realyocelestial/windtunnel/README.md

<h1> AeroFlow - A wind tunnel to visualize the airflow around objects using water vapor! </h1>
<h2>Link to Demo Video - https://www.youtube.com/watch?v=F6HdiybJe84</h2>
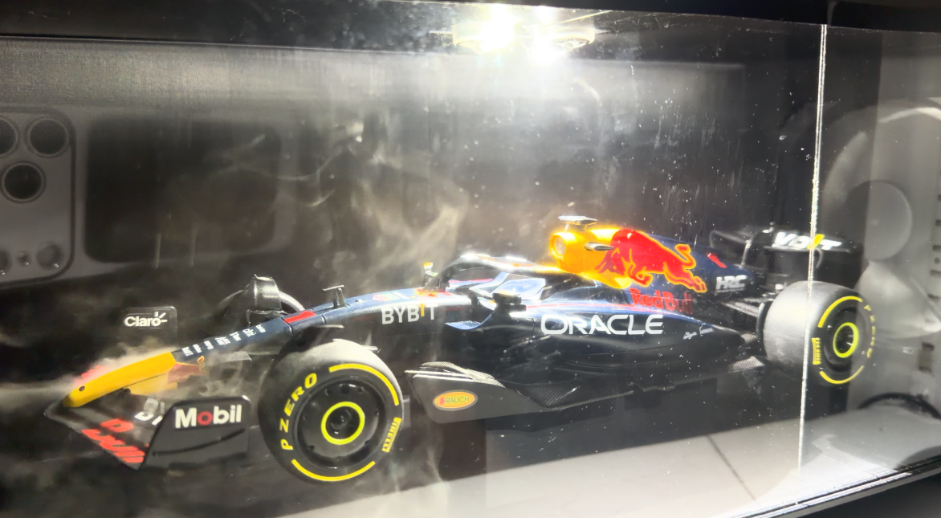
[picture p1: images/image1.png]

<h6>Best Looking Image!!!</h6>
<h2> Main Features </h2>
<ul>
  <li> Works with water vapor </li>
  <li> 3D-printed with some store bought parts </li>
  <li> 2 Heavy-duty humidifiers </li>
  <li> 120mm fan </li>
  <li> A flow shape that allows you to see many parts of the aerodynamics of a car </li>
  <li> Toggleable light on top </li>
  <li> Amazing demo video! </li>
</ul>

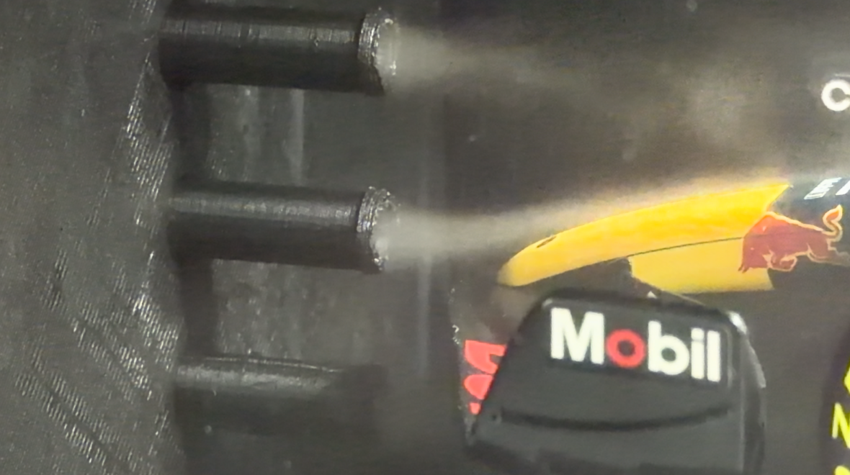
[picture p2: images/image2.png]

<h6>A demonstration of the flow!</h6>

<h2> How I Made It: </h2>
  The 3D models were made in Onshape. Hand assembled obviously. Printed with the Creality K1.
  The visualization works through sucking straightened water vapor through some tubes via a fan at the end of the tunnel
  The car is in between the tubes and the fan.

<h2> Credits </h2>
  <p>Project by @Celestial, for the Hack Club Stardance Challenge</p>
  <p>AI was used as a consultant for Onshape techniques</p>
  <p>Song used in the demonstration video: Lose My Mind by Don Toliver and Doja Cat, the F1 Movie.</p>

<h6>  I apologize for the first 11 commit messages; I did not know what the hell I was doing. im gonna try to make better commits in the future :) </h6>
