realyocelestial/windtunnel/Files/3D Models/Box Holder Thing/Box Holder Thing v1.step

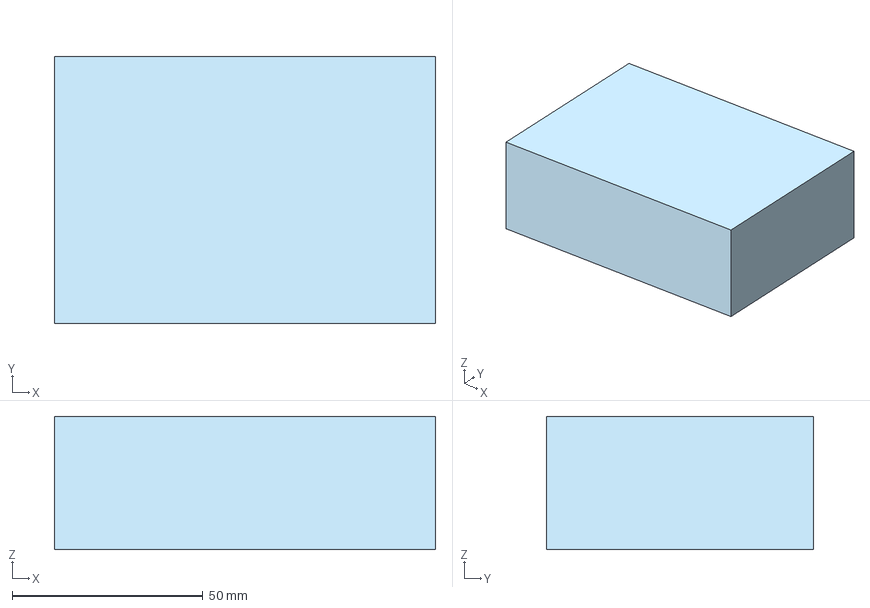
[picture p3: CAD file, 2026-10-28]
Files/3D Models/Box Holder Thing/Box Holder Thing v1.step
100.0 x 70.0 x 35.0 mm
