realyocelestial/windtunnel/Files/3D Models/Flow Shape Adapter/Flow Shape Adapter v1.step

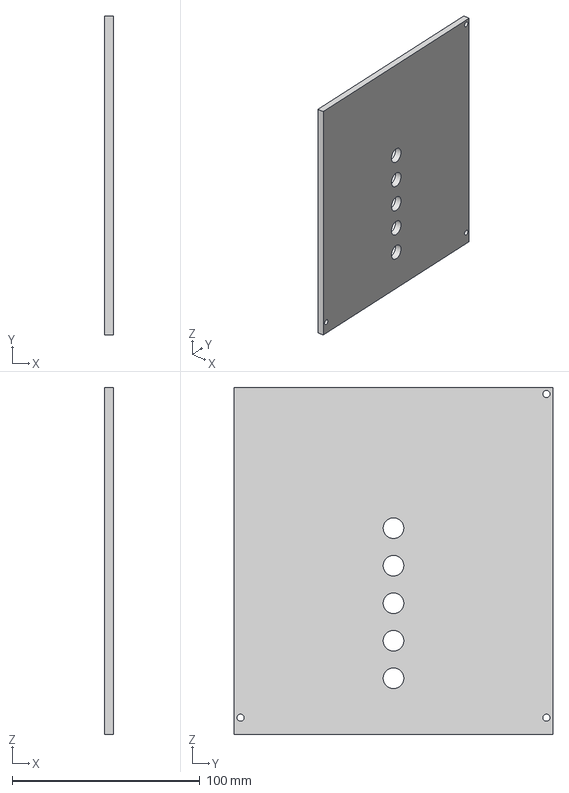
[picture p4: CAD file, 2026-10-25]
Files/3D Models/Flow Shape Adapter/Flow Shape Adapter v1.step
5.00 x 170.0 x 185.0 mm
