realyocelestial/windtunnel/Files/3D Models/Flow Shape Holder/Flow Shape Holder v2.step

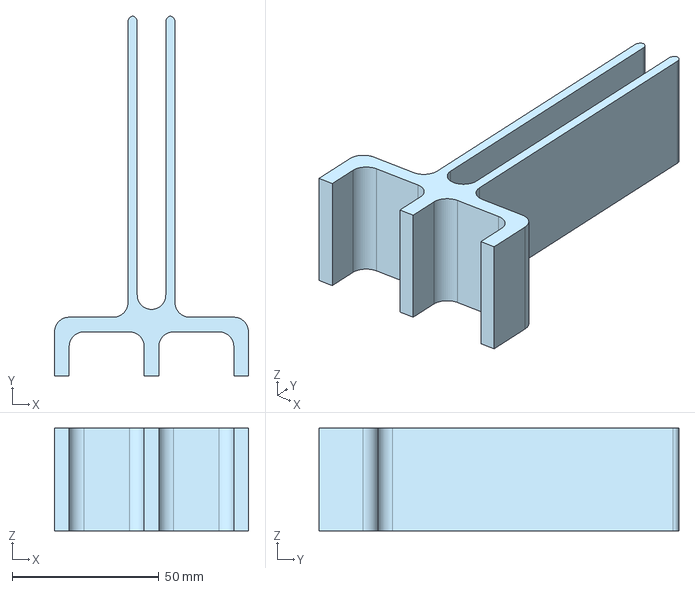
[picture p5: CAD file, 2026-10-23]
Files/3D Models/Flow Shape Holder/Flow Shape Holder v2.step
66.0 x 122.5 x 35.0 mm
