realyocelestial/windtunnel/Files/3D Models/Flow Shape Stuff/Flow Shape #1 v2.step

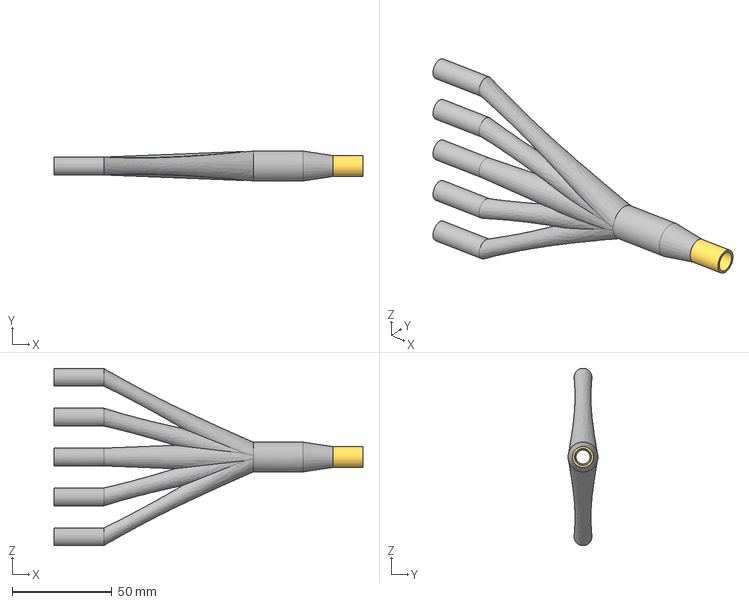
[picture p6: CAD file, 2026-10-23]
Files/3D Models/Flow Shape Stuff/Flow Shape #1 v2.step
155.0 x 15.0 x 89.0 mm
