realyocelestial/windtunnel/Files/3D Models/Honeycomb Middleman Part 1/Honeycomb Middleman Part 1 v2.step

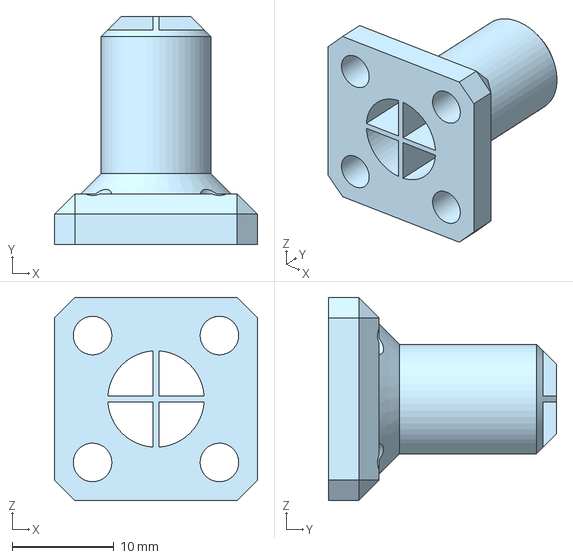
[picture p7: CAD file, 2026-10-26]
Files/3D Models/Honeycomb Middleman Part 1/Honeycomb Middleman Part 1 v2.step
20.0 x 22.5 x 20.0 mm
