realyocelestial/windtunnel/Files/3D Models/Honeycomb Middleman Part 2/Honeycomb Middleman Part 2 v1.step

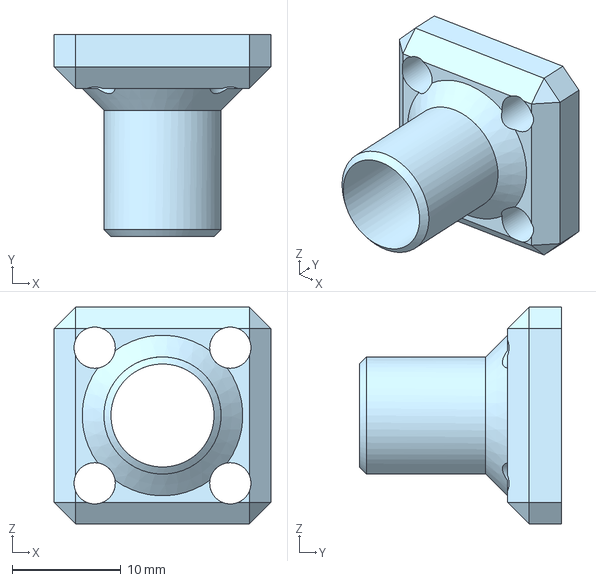
[picture p8: CAD file, 2026-10-26]
Files/3D Models/Honeycomb Middleman Part 2/Honeycomb Middleman Part 2 v1.step
20.0 x 18.6 x 20.0 mm
