realyocelestial/windtunnel/Files/3D Models/Humidification Box/Humidification Box v3.step

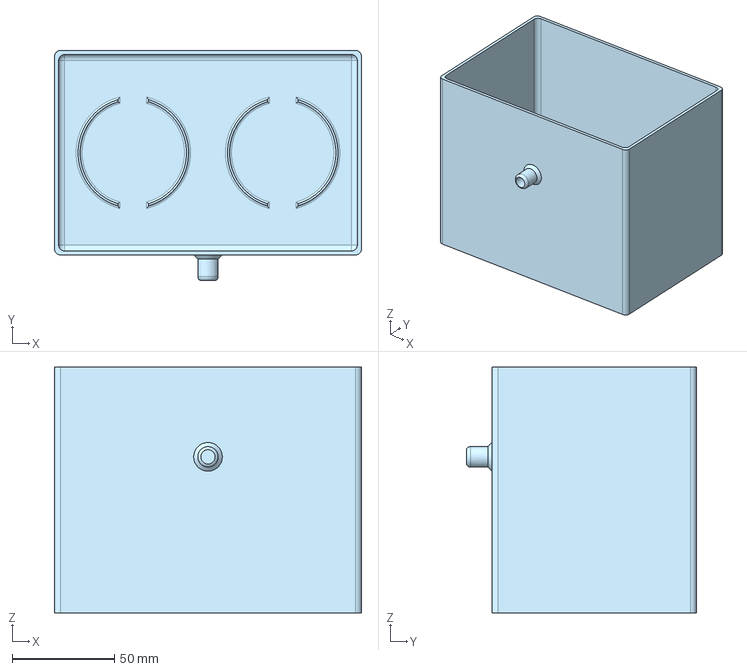
[picture p9: CAD file, 2026-10-23]
Files/3D Models/Humidification Box/Humidification Box v3.step
150.0 x 112.5 x 120.0 mm
