realyocelestial/windtunnel/Files/3D Models/Lid/Lid v3.step

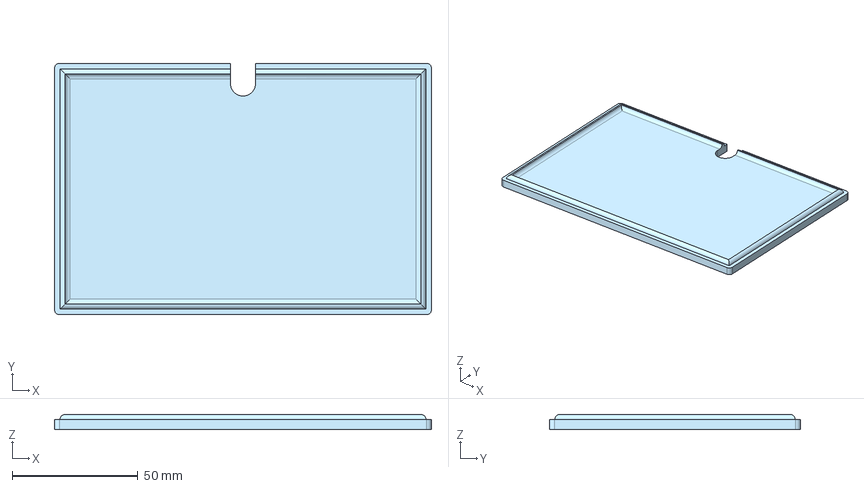
[picture p10: CAD file, 2026-10-23]
Files/3D Models/Lid/Lid v3.step
150.0 x 100.0 x 6.00 mm
