realyocelestial/windtunnel/Files/3D Models/Light Holder Thing/Light Holder Thing v2.step

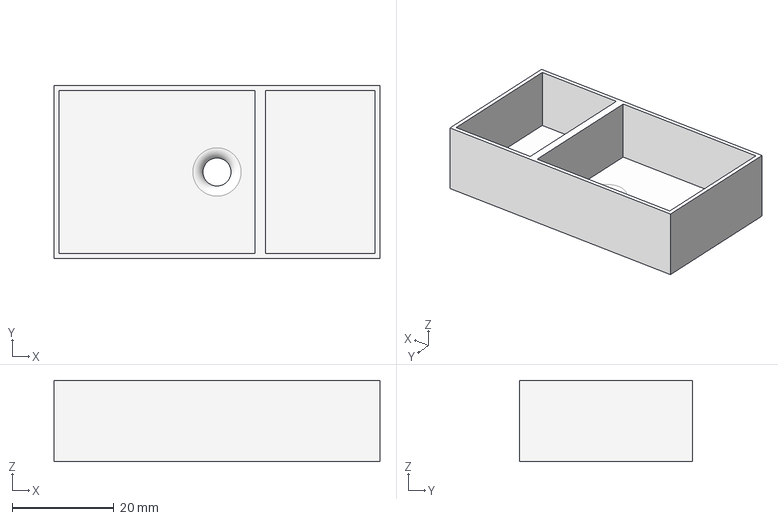
[picture p11: CAD file, 2026-10-23]
Files/3D Models/Light Holder Thing/Light Holder Thing v2.step
64.0 x 34.0 x 16.0 mm
