realyocelestial/windtunnel/Files/3D Models/Tunnel Left/TunnelLeft v5.step

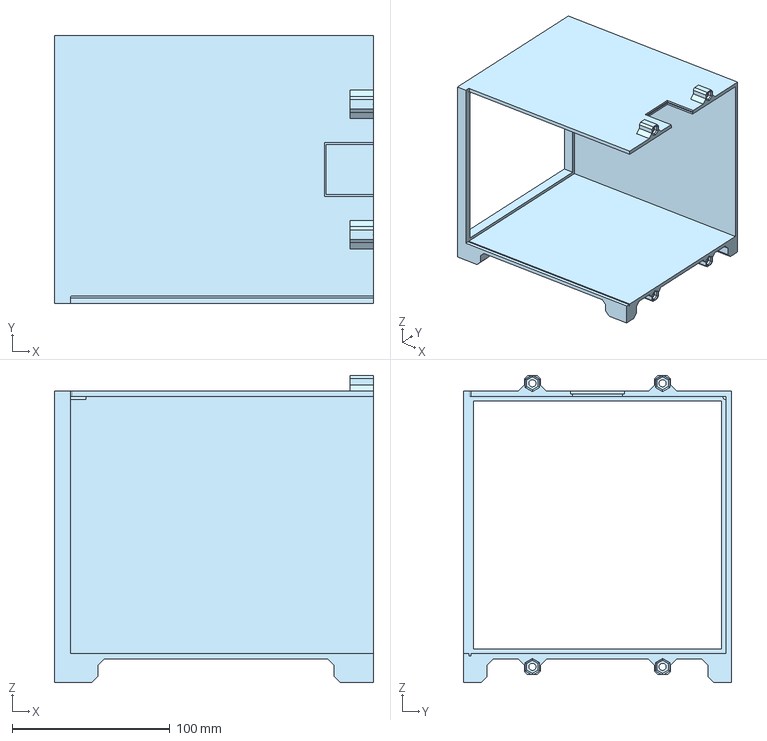
[picture p12: CAD file, 2026-10-26]
Files/3D Models/Tunnel Left/TunnelLeft v5.step
202.5 x 170.0 x 195.0 mm
