realyocelestial/windtunnel/Files/3D Models/Tunnel Right/TunnelRight v4.step

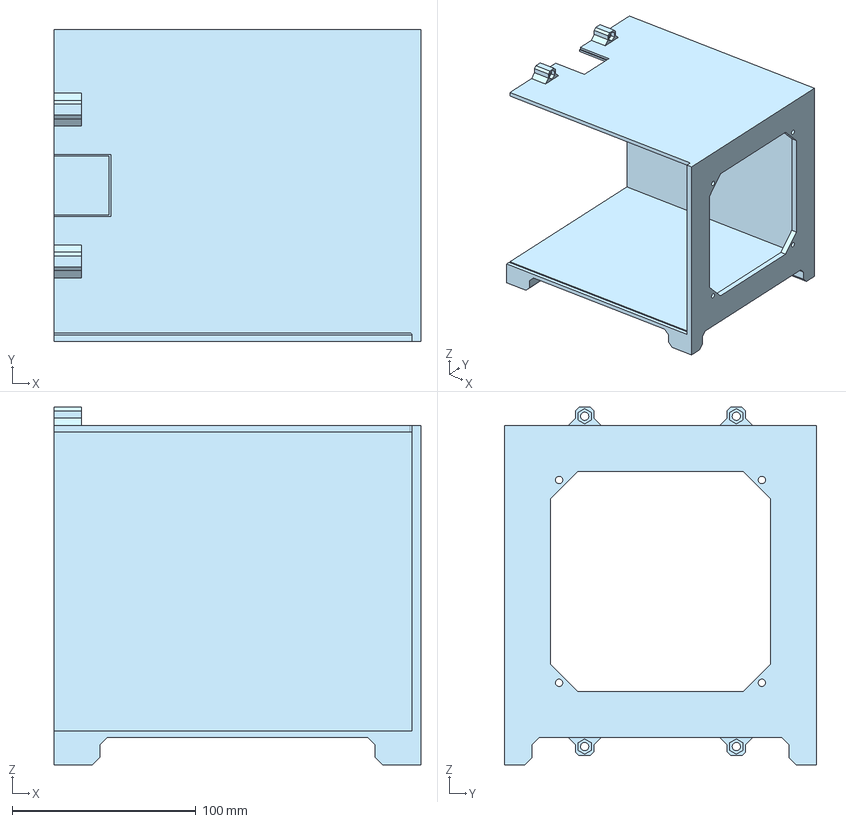
[picture p13: CAD file, 2026-10-23]
Files/3D Models/Tunnel Right/TunnelRight v4.step
200.0 x 170.0 x 195.0 mm
