realyocelestial/windtunnel/Print.3mf

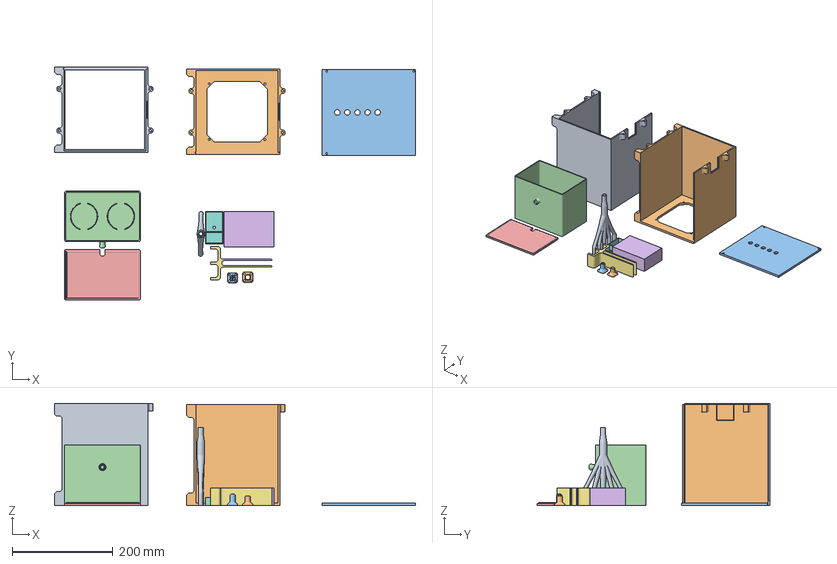
[picture p14: CAD file, 2026-10-31]
Print.3mf
715.6 x 462.3 x 202.5 mm
TunnelLeft v5.step
TunnelRight v4.step
Flow Shape Adapter v1.step
Humidification Box v4.step
Lid v3.step
Box Holder Thing v1.step
Flow Shape Holder v2.step
Light Holder Thing v2.step
Flow Shape #1 v2.step
Honeycomb Middleman Part 2 v1.step
Honeycomb Middleman Part 1 v2.step
