realyocelestial/windtunnel/Files/3D Models/Flow Shape Stuff/Flow Shape #1.step

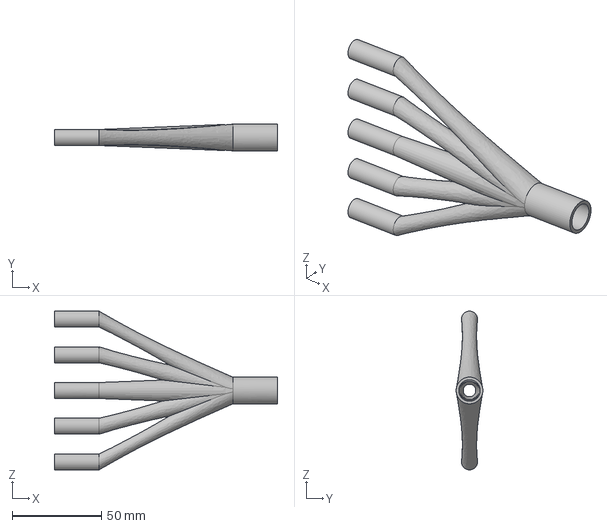
[picture p15: CAD file, 2026-10-18, an earlier design]
Files/3D Models/Flow Shape Stuff/Flow Shape #1.step
125.0 x 15.0 x 89.0 mm
