realyocelestial/windtunnel/(list of files, cad)

Other CAD files:
Files/3D Models/Flow Shape Holder/Flow Shape Holder v1.step
Files/3D Models/Humidification Box/Humidification Box v2.step
Files/3D Models/Lid/Lid v2.step
Files/3D Models/Light Holder Thing/Light Holder Thing v1.step
Files/3D Models/Tunnel Left/TunnelLeft v3.step
Files/3D Models/Tunnel Left/TunnelLeft v4.step
Files/3D Models/Tunnel Right/Tunnel RIght v1.step
Files/3D Models/Tunnel Right/TunnelRight v3.step
