realyocelestial/windtunnel/(commit log)

2026-10-11 Delete 3D Models/Tunnel Right directory
    did something wrong
    [Tunnel RIght v1.step]
2026-10-11 Delete Tunnel RIght v1.step
    attempting to add a file system (not going good)
    [Tunnel RIght v1.step]
2026-10-18 added/struggled/worked on flow shape
    [Flow Shape #1.step, HumidificationBox v1.step, Lid v1.step, Tunnel Left v1.step, Tunnel RIght v1.step, TunnelLeft v2.step, TunnelRight v2.step]
2026-10-20 adapt CAD models to fit IRL parts
    also some general improvements, like adding a flow shape holder.
    [Flow Shape #1.step, Flow Shape Holder v1.step, Humidification Box v2.step, Lid v2.step, TunnelRight v3.step]
2026-10-20 not sure why this exists
    another case of my github incompetency :isob:
    [Flow Shape #1.step, HumidificationBox v1.step, Lid v1.step, Tunnel Left v1.step, Tunnel RIght v1.step, TunnelLeft v2.step, TunnelRight v2.step]
2026-10-23 finalize 3d models
    kinda finalized them, hope theyre good.
    [Flow Shape #1 v2.step, Flow Shape Holder v2.step, Humidification Box v3.step, Lid v3.step, Light Holder Thing v1.step, TunnelLeft v3.step, TunnelRight v4.step]
2026-10-23 fix light holder thing
    added a hole for the light to go through (the reason why it wasnt there in the first place was sleep deprivation :))
    [Light Holder Thing v2.step]
2026-10-25 add adapter for the flow shape
    also added corresponding attachments/screw holes to the TunnelLeft
    [Flow Shape Adapter v1.step, TunnelLeft v4.step]
2026-10-26 add build of materials
    added some basic materials that i used, probably will update with more when i remember what i used
    [BOM.csv]
2026-10-26 modify tunnelleft and add honeycomb middleman
    [Honeycomb Middleman Part 1 v1.step, Honeycomb Middleman Part 2 v1.step, TunnelLeft v5.step]
2026-10-28 make box for holding the car up
    [Box Holder Thing v1.step]
2026-10-31 remove make print files in to do list
    i made the print files!
2026-10-31 add print files!
    [Print.3mf]
2026-10-31 add/update readme and bom
    [BOM.csv]
2026-10-31 fix sum
    [BOM.csv]
2026-10-31 declare 3d printer used
2026-10-31 fix no shipping
    [BOM.csv]
