realyocelestial/windtunnel/images/flatpartlefttunnel.jpeg

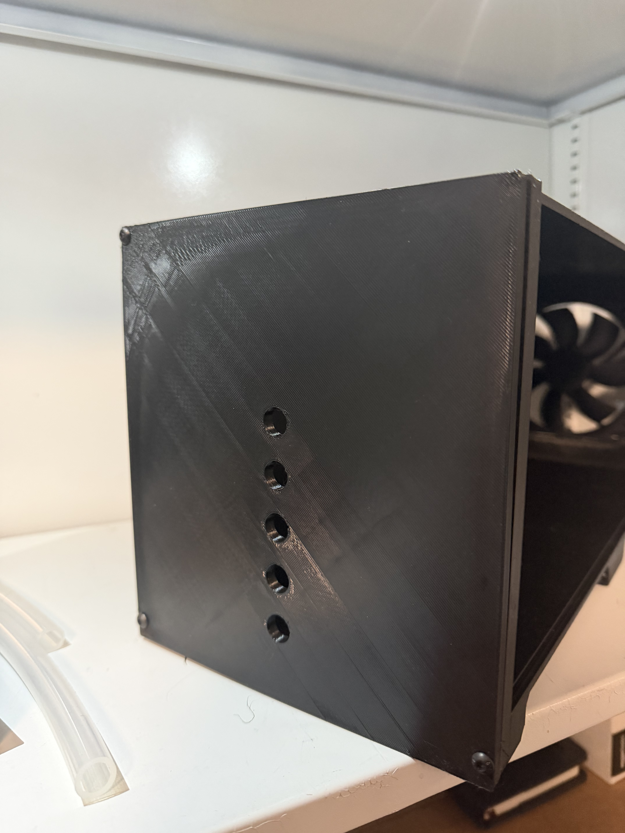
[picture p20: images/flatpartlefttunnel.jpeg]
images/flatpartlefttunnel.jpeg
